Gypsyold/E-ink-screen_Project/02_Hardware_PCB/SCH_总层次原理图_2026-06-02.pdf

# 【F407芯片核心】

## 水墨屏


原理图 | 总层次原理图 | 创建日期 | 2026-02-25
板子 | 1_总层次原理图 | 图页 | P1
绘制 | | 水墨屏demo1
审阅

更新日期 | 2026-05-06

V1.0 | A4 | 嘉立创EDA

外部高速晶振 | 外部低速晶振


原理图 | stm32F407最小系统 | 创建日期 | 2026-02-28
板子 | 2_STM32F407最小系统 | 图页 | 核心板
绘制 | | 水墨屏demo1
审阅

更新日期 | 2026-05-06


原理图 | stm32F407最小系统 | 创建日期 | 2026-02-28
板子 | 2_STM32F407最小系统 | 图页 | 电源滤波
绘制 | | 水墨屏demo1
审阅

更新日期 | 2026-03-06


原理图 | 调试下载 | 创建日期 | 2026-02-28

更新日期 | 2026-05-07

板子 | 3_调试下载 | 图页 | P1
绘制 | | 水墨屏demo1
审阅


GND GND GND

原理图 | TF卡和SPI FLASH | 创建日期 | 2026-02-28
板子 | 4_TF卡和SPI FALSH | 图页 | P1
绘制 | | 水墨屏demo1
审阅

更新日期 | 2026-05-06

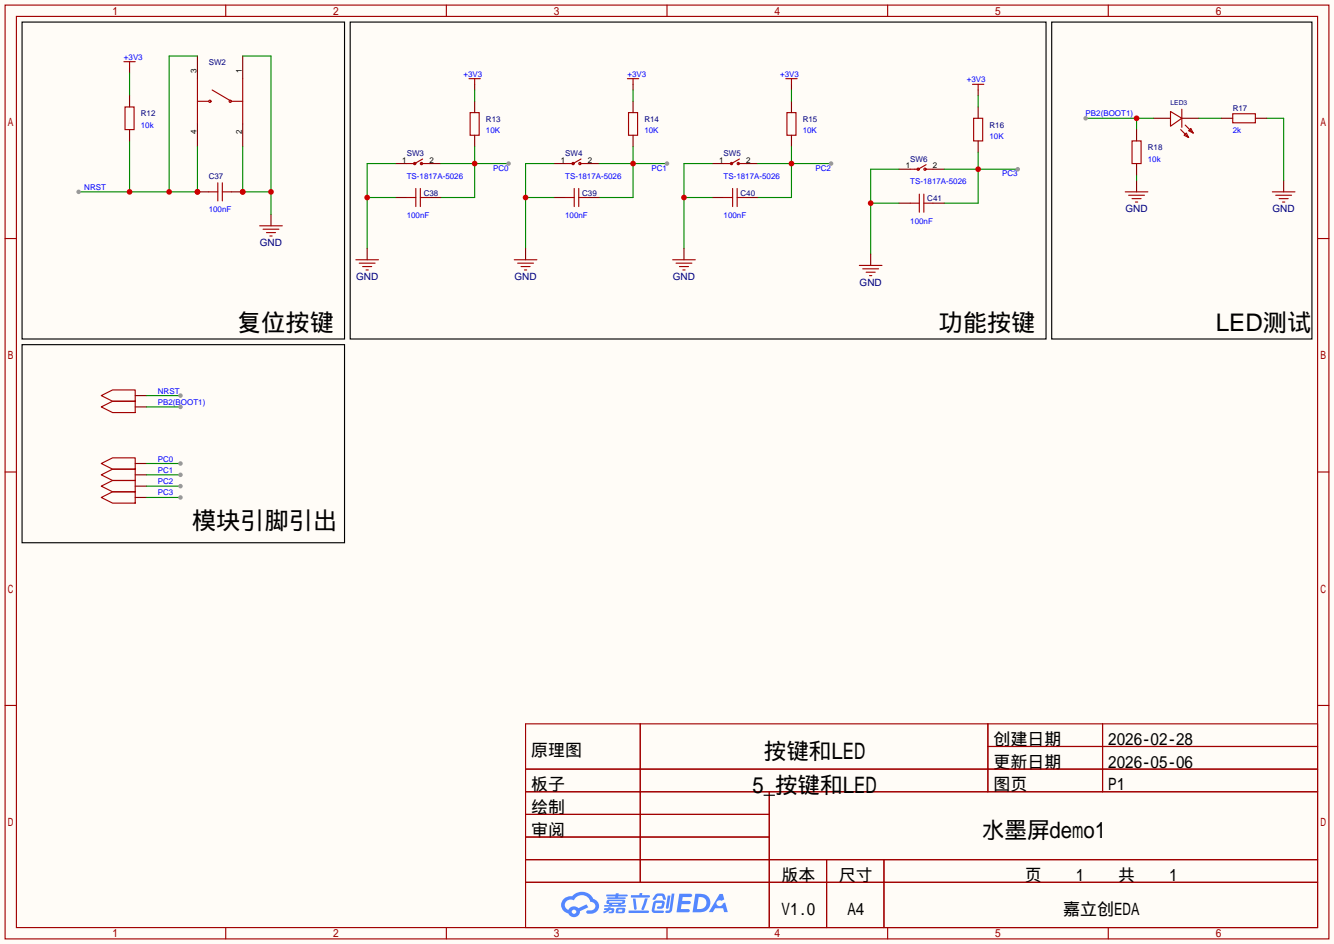
[picture p11: page 6]

原理图 | 按键和LED | 创建日期 | 2026-02-28
板子 | 5_按键和LED | 图页 | P1
绘制 | | 水墨屏demo1
审阅

更新日期 | 2026-05-06

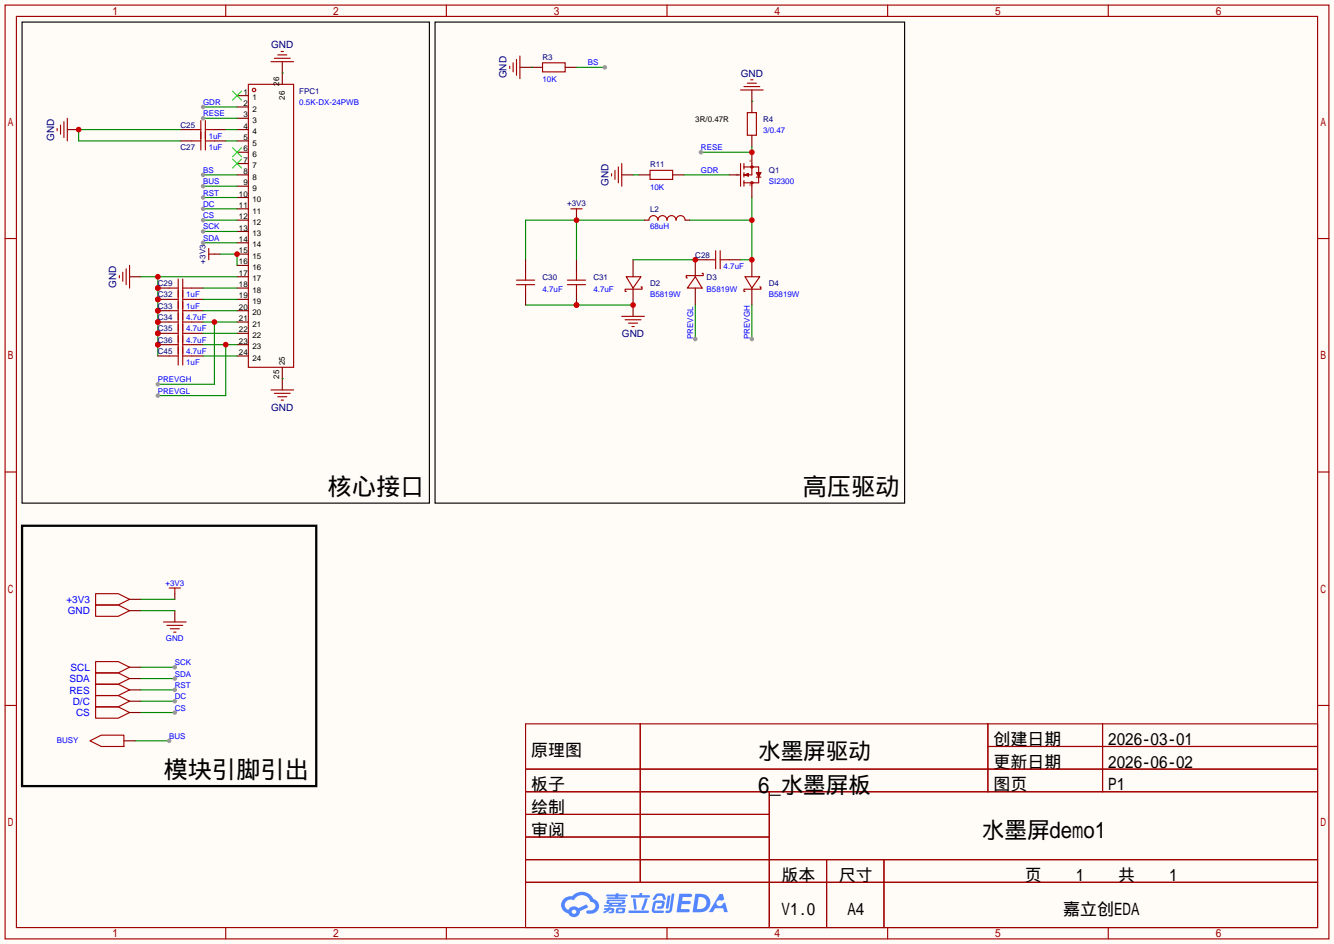
[picture p12: page 7]

原理图 | 水墨屏驱动 | 创建日期 | 2026-03-01

更新日期 | 2026-06-02

板子 | 6_水墨屏板 | 图页 | P1
绘制 | | 水墨屏demo1
审阅

开关选择 | 稳压板块

# 锂电池端口

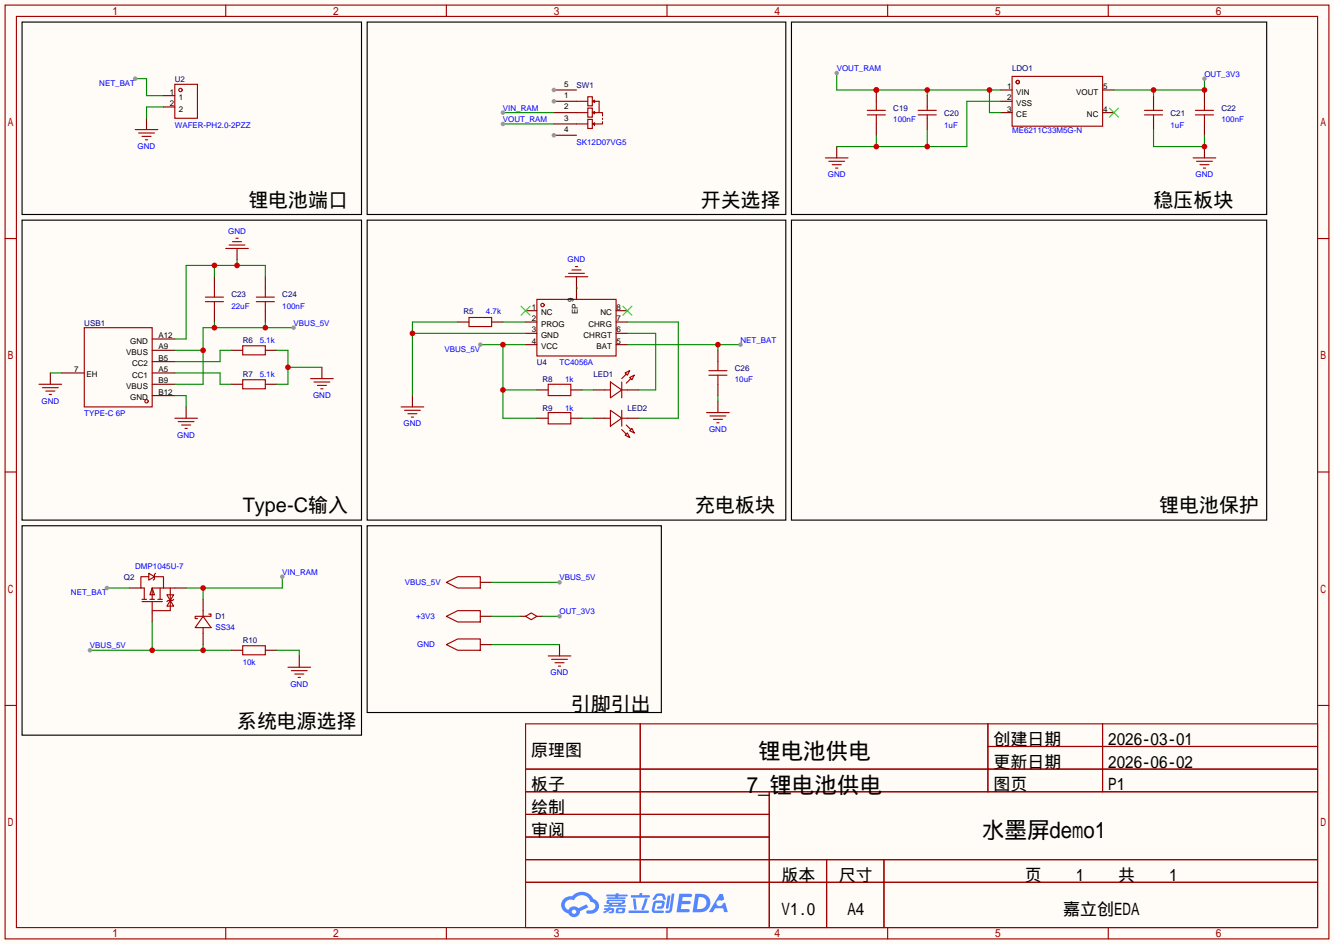
[picture p13: page 8]

原理图 | 锂电池供电 | 创建日期 | 2026-03-01
板子 | 7_锂电池供电 | 图页 | P1
绘制 | | 水墨屏demo1
审阅

更新日期 | 2026-06-02
