Gypsyold/E-ink-screen_Project/04_FreeRTOS_Integration/Wash_Ink_Screen_Internet/Core/Src/main.c

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
/* Includes ------------------------------------------------------------------*/
#include "main.h"
#include "cmsis_os.h"
#include "fatfs.h"

/* USER CODE BEGIN Includes */
#include "spi_bsp.h"
#include "ipc.h"        /* IPC_Init: 创建队列和信号量 */
#include "debug_log.h"  /* DBG_TaskStart: 串口调试任务（DBG_ENABLE=0 时编译期消除） */
#include "key_task.h"   /* Key_TaskStart */
#include "epd_task.h"   /* EPD_TaskStart */
#include "app_task.h"   /* App_Task */

#include "wifi_task.h"
/* USER CODE END Includes */

SD_HandleTypeDef hsd;
DMA_HandleTypeDef hdma_sdio_rx;
DMA_HandleTypeDef hdma_sdio_tx;

SPI_HandleTypeDef hspi1;
SPI_HandleTypeDef hspi2;
DMA_HandleTypeDef hdma_spi1_tx;
DMA_HandleTypeDef hdma_spi2_tx;

UART_HandleTypeDef huart1;
UART_HandleTypeDef huart2;

/* Definitions for defaultTask */
osThreadId_t defaultTaskHandle;
const osThreadAttr_t defaultTask_attributes = {
  .name = "defaultTask",
  .stack_size = 1024 * 4,
  .priority = (osPriority_t) osPriorityNormal,
};
void SystemClock_Config(void);
static void MX_GPIO_Init(void);
static void MX_DMA_Init(void);
static void MX_SPI1_Init(void);
static void MX_SPI2_Init(void);
static void MX_USART1_UART_Init(void);
static void MX_SDIO_SD_Init(void);
static void MX_USART2_UART_Init(void);
void StartDefaultTask(void *argument);

/**
  * @brief  The application entry point.
  * @retval int
  */
int main(void)
{

  /* MCU Configuration--------------------------------------------------------*/

  /* Reset of all peripherals, Initializes the Flash interface and the Systick. */
  HAL_Init();

  /* Configure the system clock */
  SystemClock_Config();

  /* Initialize all configured peripherals */
  MX_GPIO_Init();
  MX_DMA_Init();
  MX_SPI1_Init();
  MX_SPI2_Init();
  MX_USART1_UART_Init();
  MX_SDIO_SD_Init();
  MX_FATFS_Init();
  MX_USART2_UART_Init();
  /* USER CODE BEGIN 2 */
  SPI_BSP_Init();   /* create DMA semaphores for SPI1 and SPI2 */
  /* USER CODE END 2 */

  /* Init scheduler */
  osKernelInitialize();

  /* USER CODE BEGIN RTOS_MUTEX */
  /* add mutexes, ... */
  /* USER CODE END RTOS_MUTEX */

  /* USER CODE BEGIN RTOS_SEMAPHORES */
  /* add semaphores, ... */
  /* USER CODE END RTOS_SEMAPHORES */

  /* USER CODE BEGIN RTOS_TIMERS */
  /* start timers, add new ones, ... */
  /* USER CODE END RTOS_TIMERS */

  /* USER CODE BEGIN RTOS_QUEUES */
  IPC_Init();   /* 创建 g_key_queue / g_epd_queue / g_epd_done */
  /* USER CODE END RTOS_QUEUES */

  /* Create the thread(s) */
  /* creation of defaultTask */
  defaultTaskHandle = osThreadNew(StartDefaultTask, NULL, &defaultTask_attributes);

  /* USER CODE BEGIN RTOS_THREADS */
  DBG_TaskStart();   /* 串口调试任务：osPriorityLow，异步消费日志队列 */
  Key_TaskStart();   /* 按键扫描任务：osPriorityAboveNormal，每 10ms 采样 */
  EPD_TaskStart();   /* EPD 硬件操作任务：osPriorityNormal */
  WiFi_TaskStart();
  /* USER CODE END RTOS_THREADS */

  /* USER CODE BEGIN RTOS_EVENTS */
  /* add events, ... */
  /* USER CODE END RTOS_EVENTS */

  /* Start scheduler */
  osKernelStart();

  /* We should never get here as control is now taken by the scheduler */

  /* Infinite loop */
  /* USER CODE BEGIN WHILE */
  while (1)
  {
    /* USER CODE END WHILE */

    /* USER CODE BEGIN 3 */
  }
  /* USER CODE END 3 */
}

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
/* USER CODE BEGIN Header_StartDefaultTask */
/**
  * @brief  Function implementing the defaultTask thread.
  * @param  argument: Not used
  * @retval None
  */
/* USER CODE END Header_StartDefaultTask */
void StartDefaultTask(void *argument)
{
  /* USER CODE BEGIN 5 */
  App_Task(argument);   /* 应用主逻辑：文件浏览器 + 文件阅读器 */
  for (;;) {
      osDelay(1000);
  }
  /* USER CODE END 5 */
}

/**
  * @brief  Period elapsed callback in non blocking mode
  * @note   This function is called  when TIM6 interrupt took place, inside
  * HAL_TIM_IRQHandler(). It makes a direct call to HAL_IncTick() to increment
  * a global variable "uwTick" used as application time base.
  * @param  htim : TIM handle
  * @retval None
  */
void HAL_TIM_PeriodElapsedCallback(TIM_HandleTypeDef *htim)
{
  if (htim->Instance == TIM6)
  {
    HAL_IncTick();
  }
}

/**
  * @brief  This function is executed in case of error occurrence.
  * @retval None
  */
void Error_Handler(void)
{
  /* USER CODE BEGIN Error_Handler_Debug */
  /* User can add his own implementation to report the HAL error return state */
  __disable_irq();
  while (1)
  {
  }
  /* USER CODE END Error_Handler_Debug */
}
#ifdef USE_FULL_ASSERT
/**
  * @brief  Reports the name of the source file and the source line number
  *         where the assert_param error has occurred.
  * @param  file: pointer to the source file name
  * @param  line: assert_param error line source number
  * @retval None
  */
void assert_failed(uint8_t *file, uint32_t line)
{
  /* USER CODE BEGIN 6 */
  /* User can add his own implementation to report the file name and line number,
     ex: printf("Wrong parameters value: file %s on line %d\r\n", file, line) */
  /* USER CODE END 6 */
}
#endif /* USE_FULL_ASSERT */
