Gypsyold/E-ink-screen_Project/04_FreeRTOS_Integration/Wash_Ink_Screen_Internet/Wash_Ink_Screen_Internet.ioc

Mcu.UserName=STM32F407VGTx
PA10.Signal=USART1_RX
PA13.Signal=SYS_JTMS-SWDIO
PA14.Signal=SYS_JTCK-SWCLK
PA2.Signal=USART2_TX
PA3.Signal=USART2_RX
PA4.GPIO_Label=W25Q_CS
PA4.Signal=GPIO_Output
PA5.Signal=SPI1_SCK
PA6.Signal=SPI1_MISO
PA7.Signal=SPI1_MOSI
PA9.Signal=USART1_TX
PB12.GPIO_Label=EPD_CS
PB12.Signal=GPIO_Output
PB13.Signal=SPI2_SCK
PB15.Signal=SPI2_MOSI
PC0.GPIO_Label=KEY1
PC0.Signal=GPIO_Input
PC1.GPIO_Label=KEY2
PC1.Signal=GPIO_Input
PC10.Signal=SDIO_D2
PC11.Signal=SDIO_D3
PC12.Signal=SDIO_CK
PC2.GPIO_Label=KEY3
PC2.Signal=GPIO_Input
PC3.GPIO_Label=KEY4
PC3.Signal=GPIO_Input
PC4.GPIO_Label=EPD_RES
PC4.Signal=GPIO_Output
PC5.GPIO_Label=EPD_DC
PC5.Signal=GPIO_Output
PC6.GPIO_Label=EPD_BUSY
PC6.Signal=GPIO_Input
PC8.Signal=SDIO_D0
PC9.Signal=SDIO_D1
PD2.Signal=SDIO_CMD
PD3.GPIO_Label=SD_DET
PD3.Signal=GPIO_Input
PH0-OSC_IN.Signal=RCC_OSC_IN
PH1-OSC_OUT.Signal=RCC_OSC_OUT
