Gypsyold/E-ink-screen_Project/04_FreeRTOS_Integration/Wash_Ink_Screen_Internet/Core/Inc/main.h

#define KEY1_Pin GPIO_PIN_0
#define KEY1_GPIO_Port GPIOC
#define KEY2_Pin GPIO_PIN_1
#define KEY2_GPIO_Port GPIOC
#define KEY3_Pin GPIO_PIN_2
#define KEY3_GPIO_Port GPIOC
#define KEY4_Pin GPIO_PIN_3
#define KEY4_GPIO_Port GPIOC
#define W25Q_CS_Pin GPIO_PIN_4
#define W25Q_CS_GPIO_Port GPIOA
#define EPD_RES_Pin GPIO_PIN_4
#define EPD_RES_GPIO_Port GPIOC
#define EPD_DC_Pin GPIO_PIN_5
#define EPD_DC_GPIO_Port GPIOC
#define EPD_CS_Pin GPIO_PIN_12
#define EPD_CS_GPIO_Port GPIOB
#define EPD_BUSY_Pin GPIO_PIN_6
#define EPD_BUSY_GPIO_Port GPIOC
#define SD_DET_Pin GPIO_PIN_3
#define SD_DET_GPIO_Port GPIOD
