Gypsyold/E-ink-screen_Project/(commit log)

2025-10-14 创建整体目录并推送墨水屏驱动
2025-10-14 非阻塞式程序测试
2025-10-15 改为GB2312格式并准备菜单前提
2025-10-15 一级菜单
2025-10-16 由软件SPI改为硬件SPI传输
2025-10-16 改为硬件SPI和DMA转运
2025-10-17 测试刷新频率
2025-11-07 F407硬件SPI+DMA
2025-11-07 F407硬件SPI+DMA的FPS测试
2025-11-07 F407的FreeRTOS模板移植
2025-11-07 F407的FreeRTOS的按键功能
2026-02-06 按键+显示+字库
2026-02-06 按键检测的整理
2026-02-23 解决FatFs单页覆盖问题
2026-02-24 SD卡中实现翻页显示
2026-02-24 SD卡上翻页问题解决
2026-03-02 水墨屏原理图demo1
2026-03-02 说明文件
2026-06-02 更新硬件PCB设计文件
2026-06-05 CubeMx 添加 FreeRTOS 分层架构 EPD/Key/W25Q128 驱动
2026-06-05 加入字库
2026-06-06 显示目录
2026-06-06 目录内容显示
2026-06-06 阅读小说初步完整实现
2026-06-07 书签区增加双缓冲序列号校验
2026-06-13 更新PCB文件
2026-06-14 整理工程
2026-06-15 新增联网下载项目
2026-06-16 增加联网在线调试 - 增加配合ESP32的串口下载 - 增加微信小程序管理
2026-07-01 加入上位机管理（小程序）
2026-07-01 更新REAdME文件
2026-07-02 移除微信小程序前端密钥
