Gypsyold/E-ink-screen_Project/(notices)

Notices in the files:
04_FreeRTOS_Integration/Wash_Ink_Screen_Internet/Core/Src/main.c:
Copyright (c) 2026 STMicroelectronics.
All rights reserved.
This software is licensed under terms that can be found in the LICENSE file
